rutham5fo/QuickPageLite/synth/rtl/qpl_synth_tb_func_synth.v

// Copyright 1986-2022 Xilinx, Inc. All Rights Reserved.
// Copyright 2022-2023 Advanced Micro Devices, Inc. All Rights Reserved.
// --------------------------------------------------------------------------------
// Tool Version: Vivado v.2023.2 (win64) Build 4029153 Fri Oct 13 20:14:34 MDT 2023
// Date        : Fri Jun 13 18:02:27 2025
// Host        : LAPTOP-SRGHD2GT running 64-bit major release  (build 9200)
// Command     : write_verilog -mode funcsim -nolib -force -file
//               C:/VivadoProjects/quick_page_lite/qpl_v2/qpl_v2.sim/sim_1/synth/func/xsim/qpl_synth_tb_func_synth.v
// Design      : qpl_top
// Purpose     : This verilog netlist is a functional simulation representation of the design and should not be modified
//               or synthesized. This netlist cannot be used for SDF annotated simulation.
// Device      : xc7z020clg400-1
// --------------------------------------------------------------------------------
`timescale 1 ps / 1 ps

module axis_fifo
   (i_req_alloc_vld,
    r_sready_reg_0,
    i_req_alloc_data,
    i_rst_IBUF,
    i_clk_IBUF_BUFG,
    o_req_alloc_rdy,
    i_req_alloc_vld_IBUF,
    D);
  output i_req_alloc_vld;
  output r_sready_reg_0;
  output [17:0]i_req_alloc_data;
  input i_rst_IBUF;
  input i_clk_IBUF_BUFG;
  input o_req_alloc_rdy;
  input i_req_alloc_vld_IBUF;
  input [17:0]D;

  wire [17:0]D;
  wire data0;
  wire data2;
  wire data3;
  wire data4;
  wire data5;
  wire data6;
  wire data7;
  wire i_clk_IBUF_BUFG;
  wire [17:0]i_req_alloc_data;
  wire i_req_alloc_vld;
  wire i_req_alloc_vld_IBUF;
  wire i_rst_IBUF;
  wire o_req_alloc_rdy;
  wire [3:0]p_0_in;
  wire p_14_in;
  wire p_1_in14_in;
  wire p_3_in10_in;
  wire p_5_in7_in;
  wire r_almost_full;
  wire r_almost_full_i_1_n_0;
  wire \r_data_buf[0][17]_i_1_n_0 ;
  wire \r_data_buf[1][17]_i_1_n_0 ;
  wire \r_data_buf[2][17]_i_1_n_0 ;
  wire \r_data_buf[3][17]_i_1_n_0 ;
  wire [17:0]\r_data_buf_reg[0] ;
  wire [17:0]\r_data_buf_reg[1] ;
  wire [17:0]\r_data_buf_reg[2] ;
  wire [17:0]\r_data_buf_reg[3] ;
  wire [17:0]\r_data_buf_reg[4] ;
  wire [17:0]\r_data_buf_reg[5] ;
  wire [17:0]\r_data_buf_reg[6] ;
  wire [17:0]\r_data_buf_reg[7] ;
  wire [2:0]r_rd_ptr;
  wire \r_rd_ptr[0]_i_1_n_0 ;
  wire \r_rd_ptr[1]_i_1_n_0 ;
  wire \r_rd_ptr[2]_i_1_n_0 ;
  wire \r_skid_cntr[3]_i_1_n_0 ;
  wire [3:0]r_skid_cntr_reg;
  wire r_sready_i_1_n_0;
  wire r_sready_reg_0;
  wire \r_valid_buf[0]_i_1_n_0 ;
  wire \r_valid_buf[0]_i_2_n_0 ;
  wire \r_valid_buf[1]_i_1_n_0 ;
  wire \r_valid_buf[1]_i_2_n_0 ;
  wire \r_valid_buf[2]_i_1_n_0 ;
  wire \r_valid_buf[2]_i_2_n_0 ;
  wire \r_valid_buf[3]_i_1_n_0 ;
  wire \r_valid_buf[3]_i_2_n_0 ;
  wire \r_valid_buf[4]_i_1_n_0 ;
  wire \r_valid_buf[5]_i_1_n_0 ;
  wire \r_valid_buf[6]_i_1_n_0 ;
  wire \r_valid_buf[7]_i_1_n_0 ;
  wire \r_valid_buf_reg_n_0_[7] ;
  wire [2:0]r_wr_ptr;
  wire \r_wr_ptr[0]_i_1_n_0 ;
  wire \r_wr_ptr[1]_i_1_n_0 ;
  wire \r_wr_ptr[2]_i_1_n_0 ;
  wire skid_mst_vld_i_n_1;
  wire skid_mst_vld_i_n_2;
  wire w_rd_valid;
  wire w_wr_valid;

  LUT6 #(
    .INIT(64'h0440800801102002)) 
    r_almost_full_i_1
       (.I0(r_rd_ptr[1]),
        .I1(r_rd_ptr[0]),
        .I2(r_rd_ptr[2]),
        .I3(r_wr_ptr[2]),
        .I4(r_wr_ptr[1]),
        .I5(r_wr_ptr[0]),
        .O(r_almost_full_i_1_n_0));
  FDRE #(
    .INIT(1'b0)) 
    r_almost_full_reg
       (.C(i_clk_IBUF_BUFG),
        .CE(1'b1),
        .D(r_almost_full_i_1_n_0),
        .Q(r_almost_full),
        .R(i_rst_IBUF));
  LUT4 #(
    .INIT(16'h0004)) 
    \r_data_buf[0][17]_i_1 
       (.I0(r_wr_ptr[1]),
        .I1(w_wr_valid),
        .I2(r_wr_ptr[0]),
        .I3(r_wr_ptr[2]),
        .O(\r_data_buf[0][17]_i_1_n_0 ));
  LUT4 #(
    .INIT(16'h0040)) 
    \r_data_buf[1][17]_i_1 
       (.I0(r_wr_ptr[1]),
        .I1(r_wr_ptr[0]),
        .I2(w_wr_valid),
        .I3(r_wr_ptr[2]),
        .O(\r_data_buf[1][17]_i_1_n_0 ));
  LUT4 #(
    .INIT(16'h0020)) 
    \r_data_buf[2][17]_i_1 
       (.I0(w_wr_valid),
        .I1(r_wr_ptr[0]),
        .I2(r_wr_ptr[1]),
        .I3(r_wr_ptr[2]),
        .O(\r_data_buf[2][17]_i_1_n_0 ));
  LUT4 #(
    .INIT(16'h0080)) 
    \r_data_buf[3][17]_i_1 
       (.I0(r_wr_ptr[0]),
        .I1(w_wr_valid),
        .I2(r_wr_ptr[1]),
        .I3(r_wr_ptr[2]),
        .O(\r_data_buf[3][17]_i_1_n_0 ));
  LUT4 #(
    .INIT(16'h0020)) 
    \r_data_buf[4][17]_i_1 
       (.I0(r_wr_ptr[2]),
        .I1(r_wr_ptr[1]),
        .I2(w_wr_valid),
        .I3(r_wr_ptr[0]),
        .O(p_5_in7_in));
  LUT4 #(
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
        .R(i_rst_IBUF));
  FDRE #(
    .INIT(1'b0)) 
    \r_data_buf_reg[7][5] 
       (.C(i_clk_IBUF_BUFG),
        .CE(p_14_in),
        .D(D[5]),
        .Q(\r_data_buf_reg[7] [5]),
        .R(i_rst_IBUF));
  FDRE #(
    .INIT(1'b0)) 
    \r_data_buf_reg[7][6] 
       (.C(i_clk_IBUF_BUFG),
        .CE(p_14_in),
        .D(D[6]),
        .Q(\r_data_buf_reg[7] [6]),
        .R(i_rst_IBUF));
  FDRE #(
    .INIT(1'b0)) 
    \r_data_buf_reg[7][7] 
       (.C(i_clk_IBUF_BUFG),
        .CE(p_14_in),
        .D(D[7]),
        .Q(\r_data_buf_reg[7] [7]),
        .R(i_rst_IBUF));
  FDRE #(
    .INIT(1'b0)) 
    \r_data_buf_reg[7][8] 
       (.C(i_clk_IBUF_BUFG),
        .CE(p_14_in),
        .D(D[8]),
        .Q(\r_data_buf_reg[7] [8]),
        .R(i_rst_IBUF));
  FDRE #(
    .INIT(1'b0)) 
    \r_data_buf_reg[7][9] 
       (.C(i_clk_IBUF_BUFG),
        .CE(p_14_in),
        .D(D[9]),
        .Q(\r_data_buf_reg[7] [9]),
        .R(i_rst_IBUF));
  LUT2 #(
    .INIT(4'h6)) 
    \r_rd_ptr[0]_i_1 
       (.I0(w_rd_valid),
        .I1(r_rd_ptr[0]),
        .O(\r_rd_ptr[0]_i_1_n_0 ));
  (* SOFT_HLUTNM = "soft_lutpair5" *) 
  LUT3 #(
    .INIT(8'h78)) 
    \r_rd_ptr[1]_i_1 
       (.I0(r_rd_ptr[0]),
        .I1(w_rd_valid),
        .I2(r_rd_ptr[1]),
        .O(\r_rd_ptr[1]_i_1_n_0 ));
  (* SOFT_HLUTNM = "soft_lutpair5" *) 
  LUT4 #(
    .INIT(16'h7F80)) 
    \r_rd_ptr[2]_i_1 
       (.I0(r_rd_ptr[0]),
        .I1(r_rd_ptr[1]),
        .I2(w_rd_valid),
        .I3(r_rd_ptr[2]),
        .O(\r_rd_ptr[2]_i_1_n_0 ));
  LUT6 #(
    .INIT(64'hA8A8A88A08080880)) 
    \r_rd_ptr[2]_i_2 
       (.I0(o_req_alloc_rdy),
        .I1(skid_mst_vld_i_n_2),
        .I2(r_rd_ptr[2]),
        .I3(r_rd_ptr[0]),
        .I4(r_rd_ptr[1]),
        .I5(skid_mst_vld_i_n_1),
        .O(w_rd_valid));
  FDRE #(
    .INIT(1'b0)) 
    \r_rd_ptr_reg[0] 
       (.C(i_clk_IBUF_BUFG),
        .CE(1'b1),
        .D(\r_rd_ptr[0]_i_1_n_0 ),
        .Q(r_rd_ptr[0]),
        .R(i_rst_IBUF));
  FDRE #(
    .INIT(1'b0)) 
    \r_rd_ptr_reg[1] 
       (.C(i_clk_IBUF_BUFG),
        .CE(1'b1),
        .D(\r_rd_ptr[1]_i_1_n_0 ),
        .Q(r_rd_ptr[1]),
        .R(i_rst_IBUF));
  FDRE #(
    .INIT(1'b0)) 
    \r_rd_ptr_reg[2] 
       (.C(i_clk_IBUF_BUFG),
        .CE(1'b1),
        .D(\r_rd_ptr[2]_i_1_n_0 ),
        .Q(r_rd_ptr[2]),
        .R(i_rst_IBUF));
  LUT3 #(
    .INIT(8'h56)) 
    \r_skid_cntr[0]_i_1 
       (.I0(r_skid_cntr_reg[0]),
        .I1(i_req_alloc_vld_IBUF),
        .I2(r_sready_reg_0),
        .O(p_0_in[0]));
  (* SOFT_HLUTNM = "soft_lutpair3" *) 
  LUT4 #(
    .INIT(16'h5BA4)) 
    \r_skid_cntr[1]_i_1 
       (.I0(r_skid_cntr_reg[0]),
        .I1(i_req_alloc_vld_IBUF),
        .I2(r_sready_reg_0),
        .I3(r_skid_cntr_reg[1]),
        .O(p_0_in[1]));
  (* SOFT_HLUTNM = "soft_lutpair3" *) 
  LUT5 #(
    .INIT(32'h77EF8810)) 
    \r_skid_cntr[2]_i_1 
       (.I0(r_skid_cntr_reg[0]),
        .I1(r_skid_cntr_reg[1]),
        .I2(i_req_alloc_vld_IBUF),
        .I3(r_sready_reg_0),
        .I4(r_skid_cntr_reg[2]),
        .O(p_0_in[2]));
  LUT5 #(
    .INIT(32'hFFFFFDFE)) 
    \r_skid_cntr[3]_i_1 
       (.I0(r_sready_reg_0),
        .I1(r_skid_cntr_reg[3]),
        .I2(r_skid_cntr_reg[2]),
        .I3(r_skid_cntr_reg[0]),
        .I4(r_skid_cntr_reg[1]),
        .O(\r_skid_cntr[3]_i_1_n_0 ));
  LUT6 #(
    .INIT(64'h7F7FFEFF80800100)) 
    \r_skid_cntr[3]_i_2 
       (.I0(r_skid_cntr_reg[1]),
        .I1(r_skid_cntr_reg[0]),
        .I2(r_skid_cntr_reg[2]),
        .I3(i_req_alloc_vld_IBUF),
        .I4(r_sready_reg_0),
        .I5(r_skid_cntr_reg[3]),
        .O(p_0_in[3]));
  FDRE #(
    .INIT(1'b0)) 
    \r_skid_cntr_reg[0] 
       (.C(i_clk_IBUF_BUFG),
        .CE(\r_skid_cntr[3]_i_1_n_0 ),
        .D(p_0_in[0]),
        .Q(r_skid_cntr_reg[0]),
        .R(i_rst_IBUF));
  FDRE #(
    .INIT(1'b0)) 
    \r_skid_cntr_reg[1] 
       (.C(i_clk_IBUF_BUFG),
        .CE(\r_skid_cntr[3]_i_1_n_0 ),
        .D(p_0_in[1]),
        .Q(r_skid_cntr_reg[1]),
        .R(i_rst_IBUF));
  FDRE #(
    .INIT(1'b0)) 
    \r_skid_cntr_reg[2] 
       (.C(i_clk_IBUF_BUFG),
        .CE(\r_skid_cntr[3]_i_1_n_0 ),
        .D(p_0_in[2]),
        .Q(r_skid_cntr_reg[2]),
        .R(i_rst_IBUF));
  FDRE #(
    .INIT(1'b0)) 
    \r_skid_cntr_reg[3] 
       (.C(i_clk_IBUF_BUFG),
        .CE(\r_skid_cntr[3]_i_1_n_0 ),
        .D(p_0_in[3]),
        .Q(r_skid_cntr_reg[3]),
        .R(i_rst_IBUF));
  LUT5 #(
    .INIT(32'hFFFFFC4C)) 
    r_sready_i_1
       (.I0(w_wr_valid),
        .I1(r_sready_reg_0),
        .I2(r_almost_full),
        .I3(w_rd_valid),
        .I4(i_rst_IBUF),
        .O(r_sready_i_1_n_0));
  FDRE #(
    .INIT(1'b0)) 
    r_sready_reg
       (.C(i_clk_IBUF_BUFG),
        .CE(1'b1),
        .D(r_sready_i_1_n_0),
        .Q(r_sready_reg_0),
        .R(1'b0));
  LUT5 #(
    .INIT(32'h0000EE0E)) 
    \r_valid_buf[0]_i_1 
       (.I0(data0),
        .I1(\r_data_buf[0][17]_i_1_n_0 ),
        .I2(\r_valid_buf[0]_i_2_n_0 ),
        .I3(r_rd_ptr[2]),
        .I4(i_rst_IBUF),
        .O(\r_valid_buf[0]_i_1_n_0 ));
  LUT6 #(
    .INIT(64'h0000000040444000)) 
    \r_valid_buf[0]_i_2 
       (.I0(r_rd_ptr[0]),
        .I1(o_req_alloc_rdy),
        .I2(skid_mst_vld_i_n_2),
        .I3(r_rd_ptr[2]),
        .I4(skid_mst_vld_i_n_1),
        .I5(r_rd_ptr[1]),
        .O(\r_valid_buf[0]_i_2_n_0 ));
  LUT5 #(
    .INIT(32'h0000EE0E)) 
    \r_valid_buf[1]_i_1 
       (.I0(data7),
        .I1(\r_data_buf[1][17]_i_1_n_0 ),
        .I2(\r_valid_buf[1]_i_2_n_0 ),
        .I3(r_rd_ptr[2]),
        .I4(i_rst_IBUF),
        .O(\r_valid_buf[1]_i_1_n_0 ));
  LUT6 #(
    .INIT(64'h00000000A8000800)) 
    \r_valid_buf[1]_i_2 
       (.I0(o_req_alloc_rdy),
        .I1(skid_mst_vld_i_n_2),
        .I2(r_rd_ptr[2]),
        .I3(r_rd_ptr[0]),
        .I4(skid_mst_vld_i_n_1),
        .I5(r_rd_ptr[1]),
        .O(\r_valid_buf[1]_i_2_n_0 ));
  LUT5 #(
    .INIT(32'h0000EE0E)) 
    \r_valid_buf[2]_i_1 
       (.I0(data6),
        .I1(\r_data_buf[2][17]_i_1_n_0 ),
        .I2(\r_valid_buf[2]_i_2_n_0 ),
        .I3(r_rd_ptr[2]),
        .I4(i_rst_IBUF),
        .O(\r_valid_buf[2]_i_1_n_0 ));
  LUT6 #(
    .INIT(64'h4440000000400000)) 
    \r_valid_buf[2]_i_2 
       (.I0(r_rd_ptr[0]),
        .I1(o_req_alloc_rdy),
        .I2(skid_mst_vld_i_n_2),
        .I3(r_rd_ptr[2]),
        .I4(r_rd_ptr[1]),
        .I5(skid_mst_vld_i_n_1),
        .O(\r_valid_buf[2]_i_2_n_0 ));
  LUT5 #(
    .INIT(32'h0000EE0E)) 
    \r_valid_buf[3]_i_1 
       (.I0(data5),
        .I1(\r_data_buf[3][17]_i_1_n_0 ),
        .I2(\r_valid_buf[3]_i_2_n_0 ),
        .I3(r_rd_ptr[2]),
        .I4(i_rst_IBUF),
        .O(\r_valid_buf[3]_i_1_n_0 ));
  LUT6 #(
    .INIT(64'hA800000008000000)) 
    \r_valid_buf[3]_i_2 
       (.I0(o_req_alloc_rdy),
        .I1(skid_mst_vld_i_n_2),
        .I2(r_rd_ptr[2]),
        .I3(r_rd_ptr[0]),
        .I4(r_rd_ptr[1]),
        .I5(skid_mst_vld_i_n_1),
        .O(\r_valid_buf[3]_i_2_n_0 ));
  LUT5 #(
    .INIT(32'h00000EEE)) 
    \r_valid_buf[4]_i_1 
       (.I0(data4),
        .I1(p_5_in7_in),
        .I2(r_rd_ptr[2]),
        .I3(\r_valid_buf[0]_i_2_n_0 ),
        .I4(i_rst_IBUF),
        .O(\r_valid_buf[4]_i_1_n_0 ));
  LUT5 #(
    .INIT(32'h00000EEE)) 
    \r_valid_buf[5]_i_1 
       (.I0(data3),
        .I1(p_3_in10_in),
        .I2(r_rd_ptr[2]),
        .I3(\r_valid_buf[1]_i_2_n_0 ),
        .I4(i_rst_IBUF),
        .O(\r_valid_buf[5]_i_1_n_0 ));
  LUT5 #(
    .INIT(32'h00000EEE)) 
    \r_valid_buf[6]_i_1 
       (.I0(data2),
        .I1(p_1_in14_in),
        .I2(r_rd_ptr[2]),
        .I3(\r_valid_buf[2]_i_2_n_0 ),
        .I4(i_rst_IBUF),
        .O(\r_valid_buf[6]_i_1_n_0 ));
  LUT5 #(
    .INIT(32'h00000EEE)) 
    \r_valid_buf[7]_i_1 
       (.I0(\r_valid_buf_reg_n_0_[7] ),
        .I1(p_14_in),
        .I2(r_rd_ptr[2]),
        .I3(\r_valid_buf[3]_i_2_n_0 ),
        .I4(i_rst_IBUF),
        .O(\r_valid_buf[7]_i_1_n_0 ));
  FDRE #(
    .INIT(1'b0)) 
    \r_valid_buf_reg[0] 
       (.C(i_clk_IBUF_BUFG),
        .CE(1'b1),
        .D(\r_valid_buf[0]_i_1_n_0 ),
        .Q(data0),
        .R(1'b0));
  FDRE #(
    .INIT(1'b0)) 
    \r_valid_buf_reg[1] 
       (.C(i_clk_IBUF_BUFG),
        .CE(1'b1),
        .D(\r_valid_buf[1]_i_1_n_0 ),
        .Q(data7),
        .R(1'b0));
  FDRE #(
    .INIT(1'b0)) 
    \r_valid_buf_reg[2] 
       (.C(i_clk_IBUF_BUFG),
        .CE(1'b1),
        .D(\r_valid_buf[2]_i_1_n_0 ),
        .Q(data6),
        .R(1'b0));
  FDRE #(
    .INIT(1'b0)) 
    \r_valid_buf_reg[3] 
       (.C(i_clk_IBUF_BUFG),
        .CE(1'b1),
        .D(\r_valid_buf[3]_i_1_n_0 ),
        .Q(data5),
        .R(1'b0));
  FDRE #(
    .INIT(1'b0)) 
    \r_valid_buf_reg[4] 
       (.C(i_clk_IBUF_BUFG),
        .CE(1'b1),
        .D(\r_valid_buf[4]_i_1_n_0 ),
        .Q(data4),
        .R(1'b0));
  FDRE #(
    .INIT(1'b0)) 
    \r_valid_buf_reg[5] 
       (.C(i_clk_IBUF_BUFG),
        .CE(1'b1),
        .D(\r_valid_buf[5]_i_1_n_0 ),
        .Q(data3),
        .R(1'b0));
  FDRE #(
    .INIT(1'b0)) 
    \r_valid_buf_reg[6] 
       (.C(i_clk_IBUF_BUFG),
        .CE(1'b1),
        .D(\r_valid_buf[6]_i_1_n_0 ),
        .Q(data2),
        .R(1'b0));
  FDRE #(
    .INIT(1'b0)) 
    \r_valid_buf_reg[7] 
       (.C(i_clk_IBUF_BUFG),
        .CE(1'b1),
        .D(\r_valid_buf[7]_i_1_n_0 ),
        .Q(\r_valid_buf_reg_n_0_[7] ),
        .R(1'b0));
  LUT2 #(
    .INIT(4'h6)) 
    \r_wr_ptr[0]_i_1 
       (.I0(w_wr_valid),
        .I1(r_wr_ptr[0]),
        .O(\r_wr_ptr[0]_i_1_n_0 ));
  (* SOFT_HLUTNM = "soft_lutpair4" *) 
  LUT3 #(
    .INIT(8'h78)) 
    \r_wr_ptr[1]_i_1 
       (.I0(r_wr_ptr[0]),
        .I1(w_wr_valid),
        .I2(r_wr_ptr[1]),
        .O(\r_wr_ptr[1]_i_1_n_0 ));
  (* SOFT_HLUTNM = "soft_lutpair4" *) 
  LUT4 #(
    .INIT(16'h7F80)) 
    \r_wr_ptr[2]_i_1 
       (.I0(r_wr_ptr[0]),
        .I1(r_wr_ptr[1]),
        .I2(w_wr_valid),
        .I3(r_wr_ptr[2]),
        .O(\r_wr_ptr[2]_i_1_n_0 ));
  LUT6 #(
    .INIT(64'hAAAAAAAAAAAAAAA8)) 
    \r_wr_ptr[2]_i_2 
       (.I0(i_req_alloc_vld_IBUF),
        .I1(r_skid_cntr_reg[1]),
        .I2(r_skid_cntr_reg[0]),
        .I3(r_skid_cntr_reg[3]),
        .I4(r_skid_cntr_reg[2]),
        .I5(r_sready_reg_0),
        .O(w_wr_valid));
  FDRE #(
    .INIT(1'b0)) 
    \r_wr_ptr_reg[0] 
       (.C(i_clk_IBUF_BUFG),
        .CE(1'b1),
        .D(\r_wr_ptr[0]_i_1_n_0 ),
        .Q(r_wr_ptr[0]),
        .R(i_rst_IBUF));
  FDRE #(
    .INIT(1'b0)) 
    \r_wr_ptr_reg[1] 
       (.C(i_clk_IBUF_BUFG),
        .CE(1'b1),
        .D(\r_wr_ptr[1]_i_1_n_0 ),
        .Q(r_wr_ptr[1]),
        .R(i_rst_IBUF));
  FDRE #(
    .INIT(1'b0)) 
    \r_wr_ptr_reg[2] 
       (.C(i_clk_IBUF_BUFG),
        .CE(1'b1),
        .D(\r_wr_ptr[2]_i_1_n_0 ),
        .Q(r_wr_ptr[2]),
        .R(i_rst_IBUF));
  skids__parameterized0 skid_mst_data_i
       (.Q(\r_data_buf_reg[3] ),
        .i_clk_IBUF_BUFG(i_clk_IBUF_BUFG),
        .i_req_alloc_data(i_req_alloc_data),
        .i_rst_IBUF(i_rst_IBUF),
        .o_req_alloc_rdy(o_req_alloc_rdy),
        .r_rd_ptr(r_rd_ptr),
        .\r_sreg_reg[17]_0 (\r_data_buf_reg[2] ),
        .\r_sreg_reg[17]_1 (\r_data_buf_reg[1] ),
        .\r_sreg_reg[17]_2 (\r_data_buf_reg[0] ),
        .\r_sreg_reg[17]_3 (\r_data_buf_reg[7] ),
        .\r_sreg_reg[17]_4 (\r_data_buf_reg[6] ),
        .\r_sreg_reg[17]_5 (\r_data_buf_reg[5] ),
        .\r_sreg_reg[17]_6 (\r_data_buf_reg[4] ));
  skids_12 skid_mst_vld_i
       (.data0(data0),
        .data2(data2),
        .data3(data3),
        .data4(data4),
        .data5(data5),
        .data6(data6),
        .data7(data7),
        .i_clk_IBUF_BUFG(i_clk_IBUF_BUFG),
        .i_req_alloc_vld(i_req_alloc_vld),
        .i_rst_IBUF(i_rst_IBUF),
        .o_req_alloc_rdy(o_req_alloc_rdy),
        .r_rd_ptr(r_rd_ptr),
        .\r_sreg_reg[0]_0 (\r_valid_buf_reg_n_0_[7] ),
        .\r_valid_buf_reg[3] (skid_mst_vld_i_n_2),
        .\r_valid_buf_reg[7] (skid_mst_vld_i_n_1));
endmodule

(* ORIG_REF_NAME = "axis_fifo" *) 
module axis_fifo__parameterized0
   (o_rep_alloc_vld_OBUF,
    r_sready_reg_0,
    o_rep_alloc_data_OBUF,
    i_rst_IBUF,
    i_clk_IBUF_BUFG,
    i_rep_alloc_rdy_IBUF,
    o_rep_alloc_vld,
    o_rep_alloc_data);
  output o_rep_alloc_vld_OBUF;
  output r_sready_reg_0;
  output [14:0]o_rep_alloc_data_OBUF;
  input i_rst_IBUF;
  input i_clk_IBUF_BUFG;
  input i_rep_alloc_rdy_IBUF;
  input o_rep_alloc_vld;
  input [14:0]o_rep_alloc_data;

  wire i_clk_IBUF_BUFG;
  wire i_rep_alloc_rdy_IBUF;
  wire i_rst_IBUF;
  wire [14:0]o_rep_alloc_data;
  wire [14:0]o_rep_alloc_data_OBUF;
  wire o_rep_alloc_vld;
  wire o_rep_alloc_vld_OBUF;
  wire [3:0]p_0_in__1;
  wire p_14_in;
  wire p_1_in14_in;
  wire p_3_in10_in;
  wire p_5_in7_in;
  wire r_almost_full;
  wire r_almost_full_i_1__1_n_0;
  wire \r_data_buf[0][14]_i_1__0_n_0 ;
  wire \r_data_buf[1][14]_i_1__0_n_0 ;
  wire \r_data_buf[2][14]_i_1__0_n_0 ;
  wire \r_data_buf[3][14]_i_1__0_n_0 ;
  wire \r_data_buf_reg_n_0_[0][0] ;
  wire \r_data_buf_reg_n_0_[0][10] ;
  wire \r_data_buf_reg_n_0_[0][11] ;
  wire \r_data_buf_reg_n_0_[0][12] ;
  wire \r_data_buf_reg_n_0_[0][13] ;
  wire \r_data_buf_reg_n_0_[0][14] ;
  wire \r_data_buf_reg_n_0_[0][1] ;
  wire \r_data_buf_reg_n_0_[0][2] ;
  wire \r_data_buf_reg_n_0_[0][3] ;
  wire \r_data_buf_reg_n_0_[0][4] ;
  wire \r_data_buf_reg_n_0_[0][5] ;
  wire \r_data_buf_reg_n_0_[0][6] ;
  wire \r_data_buf_reg_n_0_[0][7] ;
  wire \r_data_buf_reg_n_0_[0][8] ;
  wire \r_data_buf_reg_n_0_[0][9] ;
  wire \r_data_buf_reg_n_0_[1][0] ;
  wire \r_data_buf_reg_n_0_[1][10] ;
  wire \r_data_buf_reg_n_0_[1][11] ;
  wire \r_data_buf_reg_n_0_[1][12] ;
  wire \r_data_buf_reg_n_0_[1][13] ;
  wire \r_data_buf_reg_n_0_[1][14] ;
  wire \r_data_buf_reg_n_0_[1][1] ;
  wire \r_data_buf_reg_n_0_[1][2] ;
  wire \r_data_buf_reg_n_0_[1][3] ;
  wire \r_data_buf_reg_n_0_[1][4] ;
  wire \r_data_buf_reg_n_0_[1][5] ;
  wire \r_data_buf_reg_n_0_[1][6] ;
  wire \r_data_buf_reg_n_0_[1][7] ;
  wire \r_data_buf_reg_n_0_[1][8] ;
  wire \r_data_buf_reg_n_0_[1][9] ;
  wire \r_data_buf_reg_n_0_[2][0] ;
  wire \r_data_buf_reg_n_0_[2][10] ;
  wire \r_data_buf_reg_n_0_[2][11] ;
  wire \r_data_buf_reg_n_0_[2][12] ;
  wire \r_data_buf_reg_n_0_[2][13] ;
  wire \r_data_buf_reg_n_0_[2][14] ;
  wire \r_data_buf_reg_n_0_[2][1] ;
  wire \r_data_buf_reg_n_0_[2][2] ;
  wire \r_data_buf_reg_n_0_[2][3] ;
  wire \r_data_buf_reg_n_0_[2][4] ;
  wire \r_data_buf_reg_n_0_[2][5] ;
  wire \r_data_buf_reg_n_0_[2][6] ;
  wire \r_data_buf_reg_n_0_[2][7] ;
  wire \r_data_buf_reg_n_0_[2][8] ;
  wire \r_data_buf_reg_n_0_[2][9] ;
  wire \r_data_buf_reg_n_0_[3][0] ;
  wire \r_data_buf_reg_n_0_[3][10] ;
  wire \r_data_buf_reg_n_0_[3][11] ;
  wire \r_data_buf_reg_n_0_[3][12] ;
  wire \r_data_buf_reg_n_0_[3][13] ;
  wire \r_data_buf_reg_n_0_[3][14] ;
  wire \r_data_buf_reg_n_0_[3][1] ;
  wire \r_data_buf_reg_n_0_[3][2] ;
  wire \r_data_buf_reg_n_0_[3][3] ;
  wire \r_data_buf_reg_n_0_[3][4] ;
  wire \r_data_buf_reg_n_0_[3][5] ;
  wire \r_data_buf_reg_n_0_[3][6] ;
  wire \r_data_buf_reg_n_0_[3][7] ;
  wire \r_data_buf_reg_n_0_[3][8] ;
  wire \r_data_buf_reg_n_0_[3][9] ;
  wire \r_data_buf_reg_n_0_[4][0] ;
  wire \r_data_buf_reg_n_0_[4][10] ;
  wire \r_data_buf_reg_n_0_[4][11] ;
  wire \r_data_buf_reg_n_0_[4][12] ;
  wire \r_data_buf_reg_n_0_[4][13] ;
  wire \r_data_buf_reg_n_0_[4][14] ;
  wire \r_data_buf_reg_n_0_[4][1] ;
  wire \r_data_buf_reg_n_0_[4][2] ;
  wire \r_data_buf_reg_n_0_[4][3] ;
  wire \r_data_buf_reg_n_0_[4][4] ;
  wire \r_data_buf_reg_n_0_[4][5] ;
  wire \r_data_buf_reg_n_0_[4][6] ;
  wire \r_data_buf_reg_n_0_[4][7] ;
  wire \r_data_buf_reg_n_0_[4][8] ;
  wire \r_data_buf_reg_n_0_[4][9] ;
  wire \r_data_buf_reg_n_0_[5][0] ;
  wire \r_data_buf_reg_n_0_[5][10] ;
  wire \r_data_buf_reg_n_0_[5][11] ;
  wire \r_data_buf_reg_n_0_[5][12] ;
  wire \r_data_buf_reg_n_0_[5][13] ;
  wire \r_data_buf_reg_n_0_[5][14] ;
  wire \r_data_buf_reg_n_0_[5][1] ;
  wire \r_data_buf_reg_n_0_[5][2] ;
  wire \r_data_buf_reg_n_0_[5][3] ;
  wire \r_data_buf_reg_n_0_[5][4] ;
  wire \r_data_buf_reg_n_0_[5][5] ;
  wire \r_data_buf_reg_n_0_[5][6] ;
  wire \r_data_buf_reg_n_0_[5][7] ;
  wire \r_data_buf_reg_n_0_[5][8] ;
  wire \r_data_buf_reg_n_0_[5][9] ;
  wire \r_data_buf_reg_n_0_[6][0] ;
  wire \r_data_buf_reg_n_0_[6][10] ;
  wire \r_data_buf_reg_n_0_[6][11] ;
  wire \r_data_buf_reg_n_0_[6][12] ;
  wire \r_data_buf_reg_n_0_[6][13] ;
  wire \r_data_buf_reg_n_0_[6][14] ;
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
    \r_rd_ptr[1]_i_1 
       (.I0(\r_rd_ptr_reg_n_0_[0] ),
        .I1(w_rd_valid),
        .I2(\r_rd_ptr_reg_n_0_[1] ),
        .O(\r_rd_ptr[1]_i_1_n_0 ));
  (* SOFT_HLUTNM = "soft_lutpair1" *) 
  LUT4 #(
    .INIT(16'h7F80)) 
    \r_rd_ptr[2]_i_1 
       (.I0(\r_rd_ptr_reg_n_0_[0] ),
        .I1(\r_rd_ptr_reg_n_0_[1] ),
        .I2(w_rd_valid),
        .I3(\r_rd_ptr_reg_n_0_[2] ),
        .O(\r_rd_ptr[2]_i_1_n_0 ));
  LUT6 #(
    .INIT(64'hA8A8A88A08080880)) 
    \r_rd_ptr[2]_i_2__1 
       (.I0(i_rep_alloc_rdy_IBUF),
        .I1(skid_mst_vld_i_n_2),
        .I2(\r_rd_ptr_reg_n_0_[2] ),
        .I3(\r_rd_ptr_reg_n_0_[0] ),
        .I4(\r_rd_ptr_reg_n_0_[1] ),
        .I5(skid_mst_vld_i_n_1),
        .O(w_rd_valid));
  FDRE #(
    .INIT(1'b0)) 
    \r_rd_ptr_reg[0] 
       (.C(i_clk_IBUF_BUFG),
        .CE(1'b1),
        .D(\r_rd_ptr[0]_i_1_n_0 ),
        .Q(\r_rd_ptr_reg_n_0_[0] ),
        .R(i_rst_IBUF));
  FDRE #(
    .INIT(1'b0)) 
    \r_rd_ptr_reg[1] 
       (.C(i_clk_IBUF_BUFG),
        .CE(1'b1),
        .D(\r_rd_ptr[1]_i_1_n_0 ),
        .Q(\r_rd_ptr_reg_n_0_[1] ),
        .R(i_rst_IBUF));
  FDRE #(
    .INIT(1'b0)) 
    \r_rd_ptr_reg[2] 
       (.C(i_clk_IBUF_BUFG),
        .CE(1'b1),
        .D(\r_rd_ptr[2]_i_1_n_0 ),
        .Q(\r_rd_ptr_reg_n_0_[2] ),
        .R(i_rst_IBUF));
  LUT3 #(
    .INIT(8'h56)) 
    \r_skid_cntr[0]_i_1__1 
       (.I0(r_skid_cntr_reg[0]),
        .I1(o_rep_alloc_vld),
        .I2(r_sready_reg_0),
        .O(p_0_in__1[0]));
  (* SOFT_HLUTNM = "soft_lutpair0" *) 
  LUT4 #(
    .INIT(16'h5BA4)) 
    \r_skid_cntr[1]_i_1__1 
       (.I0(r_skid_cntr_reg[0]),
        .I1(o_rep_alloc_vld),
        .I2(r_sready_reg_0),
        .I3(r_skid_cntr_reg[1]),
        .O(p_0_in__1[1]));
  (* SOFT_HLUTNM = "soft_lutpair0" *) 
  LUT5 #(
    .INIT(32'h77EF8810)) 
    \r_skid_cntr[2]_i_1__1 
       (.I0(r_skid_cntr_reg[0]),
        .I1(r_skid_cntr_reg[1]),
        .I2(o_rep_alloc_vld),
        .I3(r_sready_reg_0),
        .I4(r_skid_cntr_reg[2]),
        .O(p_0_in__1[2]));
  LUT5 #(
    .INIT(32'hFFFFFDFE)) 
    \r_skid_cntr[3]_i_1__1 
       (.I0(r_sready_reg_0),
        .I1(r_skid_cntr_reg[3]),
        .I2(r_skid_cntr_reg[2]),
        .I3(r_skid_cntr_reg[0]),
        .I4(r_skid_cntr_reg[1]),
        .O(\r_skid_cntr[3]_i_1__1_n_0 ));
  LUT6 #(
    .INIT(64'h7F7FFEFF80800100)) 
    \r_skid_cntr[3]_i_2__1 
       (.I0(r_skid_cntr_reg[1]),
        .I1(r_skid_cntr_reg[0]),
        .I2(r_skid_cntr_reg[2]),
        .I3(o_rep_alloc_vld),
        .I4(r_sready_reg_0),
        .I5(r_skid_cntr_reg[3]),
        .O(p_0_in__1[3]));
  FDRE #(
    .INIT(1'b0)) 
    \r_skid_cntr_reg[0] 
       (.C(i_clk_IBUF_BUFG),
        .CE(\r_skid_cntr[3]_i_1__1_n_0 ),
        .D(p_0_in__1[0]),
        .Q(r_skid_cntr_reg[0]),
        .R(i_rst_IBUF));
  FDRE #(
    .INIT(1'b0)) 
    \r_skid_cntr_reg[1] 
       (.C(i_clk_IBUF_BUFG),
        .CE(\r_skid_cntr[3]_i_1__1_n_0 ),
        .D(p_0_in__1[1]),
        .Q(r_skid_cntr_reg[1]),
        .R(i_rst_IBUF));
  FDRE #(
    .INIT(1'b0)) 
    \r_skid_cntr_reg[2] 
       (.C(i_clk_IBUF_BUFG),
        .CE(\r_skid_cntr[3]_i_1__1_n_0 ),
        .D(p_0_in__1[2]),
        .Q(r_skid_cntr_reg[2]),
        .R(i_rst_IBUF));
  FDRE #(
    .INIT(1'b0)) 
    \r_skid_cntr_reg[3] 
       (.C(i_clk_IBUF_BUFG),
        .CE(\r_skid_cntr[3]_i_1__1_n_0 ),
        .D(p_0_in__1[3]),
        .Q(r_skid_cntr_reg[3]),
        .R(i_rst_IBUF));
  LUT5 #(
    .INIT(32'hFFFFFC4C)) 
    r_sready_i_1__1
       (.I0(w_wr_valid),
        .I1(r_sready_reg_0),
        .I2(r_almost_full),
        .I3(w_rd_valid),
        .I4(i_rst_IBUF),
        .O(r_sready_i_1__1_n_0));
  FDRE #(
    .INIT(1'b0)) 
    r_sready_reg
       (.C(i_clk_IBUF_BUFG),
        .CE(1'b1),
        .D(r_sready_i_1__1_n_0),
        .Q(r_sready_reg_0),
        .R(1'b0));
  LUT5 #(
    .INIT(32'h0000EE0E)) 
    \r_valid_buf[0]_i_1__1 
       (.I0(\r_valid_buf_reg_n_0_[0] ),
        .I1(\r_data_buf[0][14]_i_1__0_n_0 ),
        .I2(\r_valid_buf[0]_i_2__1_n_0 ),
        .I3(\r_rd_ptr_reg_n_0_[2] ),
        .I4(i_rst_IBUF),
        .O(\r_valid_buf[0]_i_1__1_n_0 ));
  LUT6 #(
    .INIT(64'h0000000040444000)) 
    \r_valid_buf[0]_i_2__1 
       (.I0(\r_rd_ptr_reg_n_0_[0] ),
        .I1(i_rep_alloc_rdy_IBUF),
        .I2(skid_mst_vld_i_n_2),
        .I3(\r_rd_ptr_reg_n_0_[2] ),
        .I4(skid_mst_vld_i_n_1),
        .I5(\r_rd_ptr_reg_n_0_[1] ),
        .O(\r_valid_buf[0]_i_2__1_n_0 ));
  LUT5 #(
    .INIT(32'h0000EE0E)) 
    \r_valid_buf[1]_i_1__1 
       (.I0(\r_valid_buf_reg_n_0_[1] ),
        .I1(\r_data_buf[1][14]_i_1__0_n_0 ),
        .I2(\r_valid_buf[1]_i_2__1_n_0 ),
        .I3(\r_rd_ptr_reg_n_0_[2] ),
        .I4(i_rst_IBUF),
        .O(\r_valid_buf[1]_i_1__1_n_0 ));
  LUT6 #(
    .INIT(64'h00000000A8000800)) 
    \r_valid_buf[1]_i_2__1 
       (.I0(i_rep_alloc_rdy_IBUF),
        .I1(skid_mst_vld_i_n_2),
        .I2(\r_rd_ptr_reg_n_0_[2] ),
        .I3(\r_rd_ptr_reg_n_0_[0] ),
        .I4(skid_mst_vld_i_n_1),
        .I5(\r_rd_ptr_reg_n_0_[1] ),
        .O(\r_valid_buf[1]_i_2__1_n_0 ));
  LUT5 #(
    .INIT(32'h0000EE0E)) 
    \r_valid_buf[2]_i_1__1 
       (.I0(\r_valid_buf_reg_n_0_[2] ),
        .I1(\r_data_buf[2][14]_i_1__0_n_0 ),
        .I2(\r_valid_buf[2]_i_2__1_n_0 ),
        .I3(\r_rd_ptr_reg_n_0_[2] ),
        .I4(i_rst_IBUF),
        .O(\r_valid_buf[2]_i_1__1_n_0 ));
  LUT6 #(
    .INIT(64'h4440000000400000)) 
    \r_valid_buf[2]_i_2__1 
       (.I0(\r_rd_ptr_reg_n_0_[0] ),
        .I1(i_rep_alloc_rdy_IBUF),
        .I2(skid_mst_vld_i_n_2),
        .I3(\r_rd_ptr_reg_n_0_[2] ),
        .I4(\r_rd_ptr_reg_n_0_[1] ),
        .I5(skid_mst_vld_i_n_1),
        .O(\r_valid_buf[2]_i_2__1_n_0 ));
  LUT5 #(
    .INIT(32'h0000EE0E)) 
    \r_valid_buf[3]_i_1__1 
       (.I0(\r_valid_buf_reg_n_0_[3] ),
        .I1(\r_data_buf[3][14]_i_1__0_n_0 ),
        .I2(\r_valid_buf[3]_i_2__1_n_0 ),
        .I3(\r_rd_ptr_reg_n_0_[2] ),
        .I4(i_rst_IBUF),
        .O(\r_valid_buf[3]_i_1__1_n_0 ));
  LUT6 #(
    .INIT(64'hA800000008000000)) 
    \r_valid_buf[3]_i_2__1 
       (.I0(i_rep_alloc_rdy_IBUF),
        .I1(skid_mst_vld_i_n_2),
        .I2(\r_rd_ptr_reg_n_0_[2] ),
        .I3(\r_rd_ptr_reg_n_0_[0] ),
        .I4(\r_rd_ptr_reg_n_0_[1] ),
        .I5(skid_mst_vld_i_n_1),
        .O(\r_valid_buf[3]_i_2__1_n_0 ));
  LUT5 #(
    .INIT(32'h00000EEE)) 
    \r_valid_buf[4]_i_1__1 
       (.I0(\r_valid_buf_reg_n_0_[4] ),
        .I1(p_5_in7_in),
        .I2(\r_rd_ptr_reg_n_0_[2] ),
        .I3(\r_valid_buf[0]_i_2__1_n_0 ),
        .I4(i_rst_IBUF),
        .O(\r_valid_buf[4]_i_1__1_n_0 ));
  LUT5 #(
    .INIT(32'h00000EEE)) 
    \r_valid_buf[5]_i_1__1 
       (.I0(\r_valid_buf_reg_n_0_[5] ),
        .I1(p_3_in10_in),
        .I2(\r_rd_ptr_reg_n_0_[2] ),
        .I3(\r_valid_buf[1]_i_2__1_n_0 ),
        .I4(i_rst_IBUF),
        .O(\r_valid_buf[5]_i_1__1_n_0 ));
  LUT5 #(
    .INIT(32'h00000EEE)) 
    \r_valid_buf[6]_i_1__1 
       (.I0(\r_valid_buf_reg_n_0_[6] ),
        .I1(p_1_in14_in),
        .I2(\r_rd_ptr_reg_n_0_[2] ),
        .I3(\r_valid_buf[2]_i_2__1_n_0 ),
        .I4(i_rst_IBUF),
        .O(\r_valid_buf[6]_i_1__1_n_0 ));
  LUT5 #(
    .INIT(32'h00000EEE)) 
    \r_valid_buf[7]_i_1__1 
       (.I0(\r_valid_buf_reg_n_0_[7] ),
        .I1(p_14_in),
        .I2(\r_rd_ptr_reg_n_0_[2] ),
        .I3(\r_valid_buf[3]_i_2__1_n_0 ),
        .I4(i_rst_IBUF),
        .O(\r_valid_buf[7]_i_1__1_n_0 ));
  FDRE #(
    .INIT(1'b0)) 
    \r_valid_buf_reg[0] 
       (.C(i_clk_IBUF_BUFG),
        .CE(1'b1),
        .D(\r_valid_buf[0]_i_1__1_n_0 ),
        .Q(\r_valid_buf_reg_n_0_[0] ),
        .R(1'b0));
  FDRE #(
    .INIT(1'b0)) 
    \r_valid_buf_reg[1] 
       (.C(i_clk_IBUF_BUFG),
        .CE(1'b1),
        .D(\r_valid_buf[1]_i_1__1_n_0 ),
        .Q(\r_valid_buf_reg_n_0_[1] ),
        .R(1'b0));
  FDRE #(
    .INIT(1'b0)) 
    \r_valid_buf_reg[2] 
       (.C(i_clk_IBUF_BUFG),
        .CE(1'b1),
        .D(\r_valid_buf[2]_i_1__1_n_0 ),
        .Q(\r_valid_buf_reg_n_0_[2] ),
        .R(1'b0));
  FDRE #(
    .INIT(1'b0)) 
    \r_valid_buf_reg[3] 
       (.C(i_clk_IBUF_BUFG),
        .CE(1'b1),
        .D(\r_valid_buf[3]_i_1__1_n_0 ),
        .Q(\r_valid_buf_reg_n_0_[3] ),
        .R(1'b0));
  FDRE #(
    .INIT(1'b0)) 
    \r_valid_buf_reg[4] 
       (.C(i_clk_IBUF_BUFG),
        .CE(1'b1),
        .D(\r_valid_buf[4]_i_1__1_n_0 ),
        .Q(\r_valid_buf_reg_n_0_[4] ),
        .R(1'b0));
  FDRE #(
    .INIT(1'b0)) 
    \r_valid_buf_reg[5] 
       (.C(i_clk_IBUF_BUFG),
        .CE(1'b1),
        .D(\r_valid_buf[5]_i_1__1_n_0 ),
        .Q(\r_valid_buf_reg_n_0_[5] ),
        .R(1'b0));
  FDRE #(
    .INIT(1'b0)) 
    \r_valid_buf_reg[6] 
       (.C(i_clk_IBUF_BUFG),
        .CE(1'b1),
        .D(\r_valid_buf[6]_i_1__1_n_0 ),
        .Q(\r_valid_buf_reg_n_0_[6] ),
        .R(1'b0));
  FDRE #(
    .INIT(1'b0)) 
    \r_valid_buf_reg[7] 
       (.C(i_clk_IBUF_BUFG),
        .CE(1'b1),
        .D(\r_valid_buf[7]_i_1__1_n_0 ),
        .Q(\r_valid_buf_reg_n_0_[7] ),
        .R(1'b0));
  LUT2 #(
    .INIT(4'h6)) 
    \r_wr_ptr[0]_i_1 
       (.I0(w_wr_valid),
        .I1(\r_wr_ptr_reg_n_0_[0] ),
        .O(\r_wr_ptr[0]_i_1_n_0 ));
  (* SOFT_HLUTNM = "soft_lutpair2" *) 
  LUT3 #(
    .INIT(8'h78)) 
    \r_wr_ptr[1]_i_1 
       (.I0(\r_wr_ptr_reg_n_0_[0] ),
        .I1(w_wr_valid),
        .I2(\r_wr_ptr_reg_n_0_[1] ),
        .O(\r_wr_ptr[1]_i_1_n_0 ));
  (* SOFT_HLUTNM = "soft_lutpair2" *) 
  LUT4 #(
    .INIT(16'h7F80)) 
    \r_wr_ptr[2]_i_1 
       (.I0(\r_wr_ptr_reg_n_0_[0] ),
        .I1(\r_wr_ptr_reg_n_0_[1] ),
        .I2(w_wr_valid),
        .I3(\r_wr_ptr_reg_n_0_[2] ),
        .O(\r_wr_ptr[2]_i_1_n_0 ));
  LUT6 #(
    .INIT(64'hAAAAAAAAAAAAAAA8)) 
    \r_wr_ptr[2]_i_2__1 
       (.I0(o_rep_alloc_vld),
        .I1(r_skid_cntr_reg[1]),
        .I2(r_skid_cntr_reg[0]),
        .I3(r_skid_cntr_reg[3]),
        .I4(r_skid_cntr_reg[2]),
        .I5(r_sready_reg_0),
        .O(w_wr_valid));
  FDRE #(
    .INIT(1'b0)) 
    \r_wr_ptr_reg[0] 
       (.C(i_clk_IBUF_BUFG),
        .CE(1'b1),
        .D(\r_wr_ptr[0]_i_1_n_0 ),
        .Q(\r_wr_ptr_reg_n_0_[0] ),
        .R(i_rst_IBUF));
  FDRE #(
    .INIT(1'b0)) 
    \r_wr_ptr_reg[1] 
       (.C(i_clk_IBUF_BUFG),
        .CE(1'b1),
        .D(\r_wr_ptr[1]_i_1_n_0 ),
        .Q(\r_wr_ptr_reg_n_0_[1] ),
        .R(i_rst_IBUF));
  FDRE #(
    .INIT(1'b0)) 
    \r_wr_ptr_reg[2] 
       (.C(i_clk_IBUF_BUFG),
        .CE(1'b1),
        .D(\r_wr_ptr[2]_i_1_n_0 ),
        .Q(\r_wr_ptr_reg_n_0_[2] ),
        .R(i_rst_IBUF));
  skids__parameterized1_13 skid_mst_data_i
       (.Q({\r_data_buf_reg_n_0_[3][14] ,\r_data_buf_reg_n_0_[3][13] ,\r_data_buf_reg_n_0_[3][12] ,\r_data_buf_reg_n_0_[3][11] ,\r_data_buf_reg_n_0_[3][10] ,\r_data_buf_reg_n_0_[3][9] ,\r_data_buf_reg_n_0_[3][8] ,\r_data_buf_reg_n_0_[3][7] ,\r_data_buf_reg_n_0_[3][6] ,\r_data_buf_reg_n_0_[3][5] ,\r_data_buf_reg_n_0_[3][4] ,\r_data_buf_reg_n_0_[3][3] ,\r_data_buf_reg_n_0_[3][2] ,\r_data_buf_reg_n_0_[3][1] ,\r_data_buf_reg_n_0_[3][0] }),
        .i_clk_IBUF_BUFG(i_clk_IBUF_BUFG),
        .i_rep_alloc_rdy_IBUF(i_rep_alloc_rdy_IBUF),
        .i_rst_IBUF(i_rst_IBUF),
        .o_rep_alloc_data_OBUF(o_rep_alloc_data_OBUF),
        .\r_sreg_reg[0]_0 (\r_rd_ptr_reg_n_0_[2] ),
        .\r_sreg_reg[0]_1 (\r_rd_ptr_reg_n_0_[1] ),
        .\r_sreg_reg[0]_2 (\r_rd_ptr_reg_n_0_[0] ),
        .\r_sreg_reg[14]_0 ({\r_data_buf_reg_n_0_[2][14] ,\r_data_buf_reg_n_0_[2][13] ,\r_data_buf_reg_n_0_[2][12] ,\r_data_buf_reg_n_0_[2][11] ,\r_data_buf_reg_n_0_[2][10] ,\r_data_buf_reg_n_0_[2][9] ,\r_data_buf_reg_n_0_[2][8] ,\r_data_buf_reg_n_0_[2][7] ,\r_data_buf_reg_n_0_[2][6] ,\r_data_buf_reg_n_0_[2][5] ,\r_data_buf_reg_n_0_[2][4] ,\r_data_buf_reg_n_0_[2][3] ,\r_data_buf_reg_n_0_[2][2] ,\r_data_buf_reg_n_0_[2][1] ,\r_data_buf_reg_n_0_[2][0] }),
        .\r_sreg_reg[14]_1 ({\r_data_buf_reg_n_0_[1][14] ,\r_data_buf_reg_n_0_[1][13] ,\r_data_buf_reg_n_0_[1][12] ,\r_data_buf_reg_n_0_[1][11] ,\r_data_buf_reg_n_0_[1][10] ,\r_data_buf_reg_n_0_[1][9] ,\r_data_buf_reg_n_0_[1][8] ,\r_data_buf_reg_n_0_[1][7] ,\r_data_buf_reg_n_0_[1][6] ,\r_data_buf_reg_n_0_[1][5] ,\r_data_buf_reg_n_0_[1][4] ,\r_data_buf_reg_n_0_[1][3] ,\r_data_buf_reg_n_0_[1][2] ,\r_data_buf_reg_n_0_[1][1] ,\r_data_buf_reg_n_0_[1][0] }),
        .\r_sreg_reg[14]_2 ({\r_data_buf_reg_n_0_[0][14] ,\r_data_buf_reg_n_0_[0][13] ,\r_data_buf_reg_n_0_[0][12] ,\r_data_buf_reg_n_0_[0][11] ,\r_data_buf_reg_n_0_[0][10] ,\r_data_buf_reg_n_0_[0][9] ,\r_data_buf_reg_n_0_[0][8] ,\r_data_buf_reg_n_0_[0][7] ,\r_data_buf_reg_n_0_[0][6] ,\r_data_buf_reg_n_0_[0][5] ,\r_data_buf_reg_n_0_[0][4] ,\r_data_buf_reg_n_0_[0][3] ,\r_data_buf_reg_n_0_[0][2] ,\r_data_buf_reg_n_0_[0][1] ,\r_data_buf_reg_n_0_[0][0] }),
        .\r_sreg_reg[14]_3 ({\r_data_buf_reg_n_0_[7][14] ,\r_data_buf_reg_n_0_[7][13] ,\r_data_buf_reg_n_0_[7][12] ,\r_data_buf_reg_n_0_[7][11] ,\r_data_buf_reg_n_0_[7][10] ,\r_data_buf_reg_n_0_[7][9] ,\r_data_buf_reg_n_0_[7][8] ,\r_data_buf_reg_n_0_[7][7] ,\r_data_buf_reg_n_0_[7][6] ,\r_data_buf_reg_n_0_[7][5] ,\r_data_buf_reg_n_0_[7][4] ,\r_data_buf_reg_n_0_[7][3] ,\r_data_buf_reg_n_0_[7][2] ,\r_data_buf_reg_n_0_[7][1] ,\r_data_buf_reg_n_0_[7][0] }),
        .\r_sreg_reg[14]_4 ({\r_data_buf_reg_n_0_[6][14] ,\r_data_buf_reg_n_0_[6][13] ,\r_data_buf_reg_n_0_[6][12] ,\r_data_buf_reg_n_0_[6][11] ,\r_data_buf_reg_n_0_[6][10] ,\r_data_buf_reg_n_0_[6][9] ,\r_data_buf_reg_n_0_[6][8] ,\r_data_buf_reg_n_0_[6][7] ,\r_data_buf_reg_n_0_[6][6] ,\r_data_buf_reg_n_0_[6][5] ,\r_data_buf_reg_n_0_[6][4] ,\r_data_buf_reg_n_0_[6][3] ,\r_data_buf_reg_n_0_[6][2] ,\r_data_buf_reg_n_0_[6][1] ,\r_data_buf_reg_n_0_[6][0] }),
        .\r_sreg_reg[14]_5 ({\r_data_buf_reg_n_0_[5][14] ,\r_data_buf_reg_n_0_[5][13] ,\r_data_buf_reg_n_0_[5][12] ,\r_data_buf_reg_n_0_[5][11] ,\r_data_buf_reg_n_0_[5][10] ,\r_data_buf_reg_n_0_[5][9] ,\r_data_buf_reg_n_0_[5][8] ,\r_data_buf_reg_n_0_[5][7] ,\r_data_buf_reg_n_0_[5][6] ,\r_data_buf_reg_n_0_[5][5] ,\r_data_buf_reg_n_0_[5][4] ,\r_data_buf_reg_n_0_[5][3] ,\r_data_buf_reg_n_0_[5][2] ,\r_data_buf_reg_n_0_[5][1] ,\r_data_buf_reg_n_0_[5][0] }),
        .\r_sreg_reg[14]_6 ({\r_data_buf_reg_n_0_[4][14] ,\r_data_buf_reg_n_0_[4][13] ,\r_data_buf_reg_n_0_[4][12] ,\r_data_buf_reg_n_0_[4][11] ,\r_data_buf_reg_n_0_[4][10] ,\r_data_buf_reg_n_0_[4][9] ,\r_data_buf_reg_n_0_[4][8] ,\r_data_buf_reg_n_0_[4][7] ,\r_data_buf_reg_n_0_[4][6] ,\r_data_buf_reg_n_0_[4][5] ,\r_data_buf_reg_n_0_[4][4] ,\r_data_buf_reg_n_0_[4][3] ,\r_data_buf_reg_n_0_[4][2] ,\r_data_buf_reg_n_0_[4][1] ,\r_data_buf_reg_n_0_[4][0] }));
  skids_14 skid_mst_vld_i
       (.i_clk_IBUF_BUFG(i_clk_IBUF_BUFG),
        .i_rep_alloc_rdy_IBUF(i_rep_alloc_rdy_IBUF),
        .i_rst_IBUF(i_rst_IBUF),
        .o_rep_alloc_vld_OBUF(o_rep_alloc_vld_OBUF),
        .\r_sreg_reg[0]_0 (\r_rd_ptr_reg_n_0_[1] ),
        .\r_sreg_reg[0]_1 (\r_rd_ptr_reg_n_0_[0] ),
        .\r_sreg_reg[0]_10 (\r_valid_buf_reg_n_0_[2] ),
        .\r_sreg_reg[0]_2 (\r_rd_ptr_reg_n_0_[2] ),
        .\r_sreg_reg[0]_3 (\r_valid_buf_reg_n_0_[7] ),
        .\r_sreg_reg[0]_4 (\r_valid_buf_reg_n_0_[0] ),
        .\r_sreg_reg[0]_5 (\r_valid_buf_reg_n_0_[5] ),
        .\r_sreg_reg[0]_6 (\r_valid_buf_reg_n_0_[6] ),
        .\r_sreg_reg[0]_7 (\r_valid_buf_reg_n_0_[3] ),
        .\r_sreg_reg[0]_8 (\r_valid_buf_reg_n_0_[4] ),
        .\r_sreg_reg[0]_9 (\r_valid_buf_reg_n_0_[1] ),
        .\r_valid_buf_reg[3] (skid_mst_vld_i_n_2),
        .\r_valid_buf_reg[7] (skid_mst_vld_i_n_1));
endmodule
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
