rutham5fo/QuickPageLite/example/qpl_1wNr_heap/mem_heap.sv

`timescale 1ns / 1ps
//////////////////////////////////////////////////////////////////////////////////
// Company: 
// Engineer: 
// 
// Create Date: 13.06.2025 20:13:23
// Design Name: 
// Module Name: mem_heap
// Project Name: 
// Target Devices: 
// Tool Versions: 
// Description: 
// 
// Dependencies: 
// 
// Revision:
// Revision 0.01 - File Created
// Additional Comments:
// 
//////////////////////////////////////////////////////////////////////////////////

/*
module mem_heap #(
        parameter BLOCK_D               = 128,                  // Number of lines per block
        parameter CHANS                 = 3,                    // Total number of address channels per block
        parameter LINE_BYTE             = 64,                   // Number of bytes per line
        //------------ DERIVED ------------------
        localparam BLOCK_W              = $clog2(BLOCK_D),
        localparam ADDR_W               = BLOCK_W,
        localparam DATA_W               = LINE_BYTE * 8
    )(
        input wire                              i_clk,
        input wire                              i_rst,
        input wire  [CHANS-1:0]                 i_wr_en,
        input wire  [CHANS-1:0][BLOCK_W-1:0]    i_wr_addr,
        input wire  [CHANS-1:0][BLOCK_W-1:0]    i_rd_addr,
        input wire  [CHANS-1:0][DATA_W-1:0]     i_wr_data,
        
        output wire [CHANS-1:0][DATA_W-1:0]     o_rd_data
    );
    
    localparam BRAM_DW              = 64;
    localparam BRAM_AW              = 9;
    localparam BRAM_CNT             = DATA_W / 64;
    
    wire    [7:0]                       w_wr_en;
    wire    [BRAM_AW-1:0]               w_wr_addr;
    wire    [BRAM_AW-1:0]               w_rd_addr;
    wire    [DATA_W-1:0]                w_wr_data;
    wire    [DATA_W-1:0]                w_rd_data;
    
    reg     [CHANS-1:0][DATA_W-1:0]     r_rd_data;
    reg     [3:0]                       r_port_sel;
    
    assign w_rd_addr = i_rd_addr[r_port_sel];
    assign w_wr_addr = i_wr_addr[r_port_sel];
    assign w_wr_data = i_wr_data[r_port_sel];
    assign w_wr_en = {{8{i_wr_en[r_port_sel]}}};
    
    assign o_rd_data = r_rd_data;
    
    genvar i;
    integer k;
    
            ///////////////////////////////////////////////////////////////////////
			//  READ_WIDTH | BRAM_SIZE | READ Depth  | RDADDR Width |            //
			// WRITE_WIDTH |           | WRITE Depth | WRADDR Width |  WE Width  //
			// ============|===========|=============|==============|============//
			//    37-72    |  "36Kb"   |      512    |     9-bit    |    8-bit   //
			//    19-36    |  "36Kb"   |     1024    |    10-bit    |    4-bit   //
			//    19-36    |  "18Kb"   |      512    |     9-bit    |    4-bit   //
			//    10-18    |  "36Kb"   |     2048    |    11-bit    |    2-bit   //
			//    10-18    |  "18Kb"   |     1024    |    10-bit    |    2-bit   //
			//     5-9     |  "36Kb"   |     4096    |    12-bit    |    1-bit   //
			//     5-9     |  "18Kb"   |     2048    |    11-bit    |    1-bit   //
			//     3-4     |  "36Kb"   |     8192    |    13-bit    |    1-bit   //
			//     3-4     |  "18Kb"   |     4096    |    12-bit    |    1-bit   //
			//       2     |  "36Kb"   |    16384    |    14-bit    |    1-bit   //
			//       2     |  "18Kb"   |     8192    |    13-bit    |    1-bit   //
			//       1     |  "36Kb"   |    32768    |    15-bit    |    1-bit   //
			//       1     |  "18Kb"   |    16384    |    14-bit    |    1-bit   //
			///////////////////////////////////////////////////////////////////////
			
    generate
        for (i = 0; i < BRAM_CNT; i = i+1) begin        :   gen_bram
            BRAM_SDP_MACRO #(
				.BRAM_SIZE("36Kb"), // Target BRAM, "18Kb" or "36Kb"
				.DEVICE("7SERIES"), // Target device: "7SERIES"
				.WRITE_WIDTH(BRAM_DW),    // Valid values are 1-72 (37-72 only valid when BRAM_SIZE="36Kb")
				.READ_WIDTH(BRAM_DW),     // Valid values are 1-72 (37-72 only valid when BRAM_SIZE="36Kb")
				.DO_REG(1'b0),         // Optional output register (0 or 1)
				.INIT_FILE ("NONE"),
				.SIM_COLLISION_CHECK ("ALL"), // Collision check enable "ALL", "WARNING_ONLY",
												//   "GENERATE_X_ONLY" or "NONE"
				.SRVAL(72'h000000000000000000), // Set/Reset value for port output
				.INIT(72'h000000000000000000),  // Initial values on output port
				.WRITE_MODE("READ_FIRST"),  // Specify "READ_FIRST" for same clock or synchronous clocks
												//   Specify "WRITE_FIRST for asynchronous clocks on ports
				.INIT_00(256'h0000000000000000000000000000000000000000000000000000000000000000),
				.INIT_01(256'h0000000000000000000000000000000000000000000000000000000000000000),
				.INIT_02(256'h0000000000000000000000000000000000000000000000000000000000000000),
				.INIT_03(256'h0000000000000000000000000000000000000000000000000000000000000000),
				.INIT_04(256'h0000000000000000000000000000000000000000000000000000000000000000),
				.INIT_05(256'h0000000000000000000000000000000000000000000000000000000000000000),
				.INIT_06(256'h0000000000000000000000000000000000000000000000000000000000000000),
				.INIT_07(256'h0000000000000000000000000000000000000000000000000000000000000000),
				.INIT_08(256'h0000000000000000000000000000000000000000000000000000000000000000),
				.INIT_09(256'h0000000000000000000000000000000000000000000000000000000000000000),
				.INIT_0A(256'h0000000000000000000000000000000000000000000000000000000000000000),
				.INIT_0B(256'h0000000000000000000000000000000000000000000000000000000000000000),
				.INIT_0C(256'h0000000000000000000000000000000000000000000000000000000000000000),
				.INIT_0D(256'h0000000000000000000000000000000000000000000000000000000000000000),
				.INIT_0E(256'h0000000000000000000000000000000000000000000000000000000000000000),
				.INIT_0F(256'h0000000000000000000000000000000000000000000000000000000000000000),
				.INIT_10(256'h0000000000000000000000000000000000000000000000000000000000000000),
				.INIT_11(256'h0000000000000000000000000000000000000000000000000000000000000000),
				.INIT_12(256'h0000000000000000000000000000000000000000000000000000000000000000),
				.INIT_13(256'h0000000000000000000000000000000000000000000000000000000000000000),
				.INIT_14(256'h0000000000000000000000000000000000000000000000000000000000000000),
				.INIT_15(256'h0000000000000000000000000000000000000000000000000000000000000000),
				.INIT_16(256'h0000000000000000000000000000000000000000000000000000000000000000),
				.INIT_17(256'h0000000000000000000000000000000000000000000000000000000000000000),
				.INIT_18(256'h0000000000000000000000000000000000000000000000000000000000000000),
				.INIT_19(256'h0000000000000000000000000000000000000000000000000000000000000000),
				.INIT_1A(256'h0000000000000000000000000000000000000000000000000000000000000000),
				.INIT_1B(256'h0000000000000000000000000000000000000000000000000000000000000000),
				.INIT_1C(256'h0000000000000000000000000000000000000000000000000000000000000000),
				.INIT_1D(256'h0000000000000000000000000000000000000000000000000000000000000000),
				.INIT_1E(256'h0000000000000000000000000000000000000000000000000000000000000000),
				.INIT_1F(256'h0000000000000000000000000000000000000000000000000000000000000000),
				.INIT_20(256'h0000000000000000000000000000000000000000000000000000000000000000),
				.INIT_21(256'h0000000000000000000000000000000000000000000000000000000000000000),
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
				.INIT_76(256'h0000000000000000000000000000000000000000000000000000000000000000),
				.INIT_77(256'h0000000000000000000000000000000000000000000000000000000000000000),
				.INIT_78(256'h0000000000000000000000000000000000000000000000000000000000000000),
				.INIT_79(256'h0000000000000000000000000000000000000000000000000000000000000000),
				.INIT_7A(256'h0000000000000000000000000000000000000000000000000000000000000000),
				.INIT_7B(256'h0000000000000000000000000000000000000000000000000000000000000000),
				.INIT_7C(256'h0000000000000000000000000000000000000000000000000000000000000000),
				.INIT_7D(256'h0000000000000000000000000000000000000000000000000000000000000000),
				.INIT_7E(256'h0000000000000000000000000000000000000000000000000000000000000000),
				.INIT_7F(256'h0000000000000000000000000000000000000000000000000000000000000000),
				
				// The next set of INITP_xx are for the parity bits
				.INITP_00(256'h0000000000000000000000000000000000000000000000000000000000000000),
				.INITP_01(256'h0000000000000000000000000000000000000000000000000000000000000000),
				.INITP_02(256'h0000000000000000000000000000000000000000000000000000000000000000),
				.INITP_03(256'h0000000000000000000000000000000000000000000000000000000000000000),
				.INITP_04(256'h0000000000000000000000000000000000000000000000000000000000000000),
				.INITP_05(256'h0000000000000000000000000000000000000000000000000000000000000000),
				.INITP_06(256'h0000000000000000000000000000000000000000000000000000000000000000),
				.INITP_07(256'h0000000000000000000000000000000000000000000000000000000000000000),
				
				// The next set of INITP_xx are valid when configured as 36Kb
				.INITP_08(256'h0000000000000000000000000000000000000000000000000000000000000000),
				.INITP_09(256'h0000000000000000000000000000000000000000000000000000000000000000),
				.INITP_0A(256'h0000000000000000000000000000000000000000000000000000000000000000),
				.INITP_0B(256'h0000000000000000000000000000000000000000000000000000000000000000),
				.INITP_0C(256'h0000000000000000000000000000000000000000000000000000000000000000),
				.INITP_0D(256'h0000000000000000000000000000000000000000000000000000000000000000),
				.INITP_0E(256'h0000000000000000000000000000000000000000000000000000000000000000),
				.INITP_0F(256'h0000000000000000000000000000000000000000000000000000000000000000)
			) BRAM_SDP_MACRO_inst (
				.DO(w_rd_data[i*BRAM_DW +: BRAM_DW]),         // Output read data port, width defined by READ_WIDTH parameter
				.DI(w_wr_data[i*BRAM_DW +: BRAM_DW]),         // Input write data port, width defined by WRITE_WIDTH parameter
				.RDADDR(w_rd_addr), // Input read address, width defined by read port depth
				.RDCLK(i_clk),   // 1-bit input read clock
				.RDEN(1'b1),     // 1-bit input read port enable
				.REGCE(1'b0),   // 1-bit input read output register enable
				.RST(i_rst),       // 1-bit input reset
				.WE(w_wr_en),         // Input write enable, width defined by write port depth
				.WRADDR(w_wr_addr), // Input write address, width defined by write port depth
				.WRCLK(i_clk),   // 1-bit input write clock
				.WREN(1'b1)      // 1-bit input write port enable
			);
        end
    endgenerate
    
    always @(posedge i_clk) begin
        r_port_sel <= (i_rst || r_port_sel == CHANS-1) ? 0 : r_port_sel + 1;
    end
    
    initial begin
        r_rd_data = 0;
    end
    
    always @(posedge i_clk) begin
        for (k = 0; k < CHANS; k = k+1) begin
            if (r_port_sel == k) r_rd_data[k] <= w_rd_data;
        end
    end
    
endmodule
*/

module mem_heap #(
        parameter CHANS                 = 3,                    // Total number of address channels per block
        parameter DATA_W                = 64,
        parameter ADDR_W                = 9
    )(
        input wire                              i_wr_clk,
        input wire                              i_rd_clk,
        input wire                              i_rst,
        input wire                              i_wr_en,
        input wire  [ADDR_W-1:0]                i_wr_addr,
        input wire  [DATA_W-1:0]                i_wr_data,
        input wire  [CHANS-1:0][ADDR_W-1:0]     i_rd_addr,
        
        output wire [CHANS-1:0][DATA_W-1:0]     o_rd_data
    );
    
    wire    [7:0]                       w_wr_en;
    
    reg     [CHANS-1:0][DATA_W-1:0]     r_rd_data;
    
    assign w_wr_en = {8{i_wr_en}};
    
    genvar i;
    
            ///////////////////////////////////////////////////////////////////////
			//  READ_WIDTH | BRAM_SIZE | READ Depth  | RDADDR Width |            //
			// WRITE_WIDTH |           | WRITE Depth | WRADDR Width |  WE Width  //
			// ============|===========|=============|==============|============//
			//    37-72    |  "36Kb"   |      512    |     9-bit    |    8-bit   //
			//    19-36    |  "36Kb"   |     1024    |    10-bit    |    4-bit   //
			//    19-36    |  "18Kb"   |      512    |     9-bit    |    4-bit   //
			//    10-18    |  "36Kb"   |     2048    |    11-bit    |    2-bit   //
			//    10-18    |  "18Kb"   |     1024    |    10-bit    |    2-bit   //
			//     5-9     |  "36Kb"   |     4096    |    12-bit    |    1-bit   //
			//     5-9     |  "18Kb"   |     2048    |    11-bit    |    1-bit   //
			//     3-4     |  "36Kb"   |     8192    |    13-bit    |    1-bit   //
			//     3-4     |  "18Kb"   |     4096    |    12-bit    |    1-bit   //
			//       2     |  "36Kb"   |    16384    |    14-bit    |    1-bit   //
			//       2     |  "18Kb"   |     8192    |    13-bit    |    1-bit   //
			//       1     |  "36Kb"   |    32768    |    15-bit    |    1-bit   //
			//       1     |  "18Kb"   |    16384    |    14-bit    |    1-bit   //
			///////////////////////////////////////////////////////////////////////
			
    generate
        for (i = 0; i < CHANS; i = i+1) begin        :   gen_bram
            BRAM_SDP_MACRO #(
				.BRAM_SIZE("36Kb"), // Target BRAM, "18Kb" or "36Kb"
				.DEVICE("7SERIES"), // Target device: "7SERIES"
				.WRITE_WIDTH(DATA_W),    // Valid values are 1-72 (37-72 only valid when BRAM_SIZE="36Kb")
				.READ_WIDTH(DATA_W),     // Valid values are 1-72 (37-72 only valid when BRAM_SIZE="36Kb")
				.DO_REG(1'b1),         // Optional output register (0 or 1)
				.INIT_FILE ("NONE"),
				.SIM_COLLISION_CHECK ("ALL"), // Collision check enable "ALL", "WARNING_ONLY",
												//   "GENERATE_X_ONLY" or "NONE"
				.SRVAL(72'h000000000000000000), // Set/Reset value for port output
				.INIT(72'h000000000000000000),  // Initial values on output port
				.WRITE_MODE("WRITE_FIRST"),  // Specify "READ_FIRST" for same clock or synchronous clocks
												//   Specify "WRITE_FIRST for asynchronous clocks on ports
				.INIT_00(256'h0000000000000000000000000000000000000000000000000000000000000000),
				.INIT_01(256'h0000000000000000000000000000000000000000000000000000000000000000),
				.INIT_02(256'h0000000000000000000000000000000000000000000000000000000000000000),
				.INIT_03(256'h0000000000000000000000000000000000000000000000000000000000000000),
				.INIT_04(256'h0000000000000000000000000000000000000000000000000000000000000000),
				.INIT_05(256'h0000000000000000000000000000000000000000000000000000000000000000),
				.INIT_06(256'h0000000000000000000000000000000000000000000000000000000000000000),
				.INIT_07(256'h0000000000000000000000000000000000000000000000000000000000000000),
				.INIT_08(256'h0000000000000000000000000000000000000000000000000000000000000000),
				.INIT_09(256'h0000000000000000000000000000000000000000000000000000000000000000),
				.INIT_0A(256'h0000000000000000000000000000000000000000000000000000000000000000),
				.INIT_0B(256'h0000000000000000000000000000000000000000000000000000000000000000),
				.INIT_0C(256'h0000000000000000000000000000000000000000000000000000000000000000),
				.INIT_0D(256'h0000000000000000000000000000000000000000000000000000000000000000),
				.INIT_0E(256'h0000000000000000000000000000000000000000000000000000000000000000),
				.INIT_0F(256'h0000000000000000000000000000000000000000000000000000000000000000),
				.INIT_10(256'h0000000000000000000000000000000000000000000000000000000000000000),
				.INIT_11(256'h0000000000000000000000000000000000000000000000000000000000000000),
				.INIT_12(256'h0000000000000000000000000000000000000000000000000000000000000000),
				.INIT_13(256'h0000000000000000000000000000000000000000000000000000000000000000),
				.INIT_14(256'h0000000000000000000000000000000000000000000000000000000000000000),
				.INIT_15(256'h0000000000000000000000000000000000000000000000000000000000000000),
				.INIT_16(256'h0000000000000000000000000000000000000000000000000000000000000000),
				.INIT_17(256'h0000000000000000000000000000000000000000000000000000000000000000),
				.INIT_18(256'h0000000000000000000000000000000000000000000000000000000000000000),
				.INIT_19(256'h0000000000000000000000000000000000000000000000000000000000000000),
				.INIT_1A(256'h0000000000000000000000000000000000000000000000000000000000000000),
				.INIT_1B(256'h0000000000000000000000000000000000000000000000000000000000000000),
				.INIT_1C(256'h0000000000000000000000000000000000000000000000000000000000000000),
				.INIT_1D(256'h0000000000000000000000000000000000000000000000000000000000000000),
				.INIT_1E(256'h0000000000000000000000000000000000000000000000000000000000000000),
				.INIT_1F(256'h0000000000000000000000000000000000000000000000000000000000000000),
				.INIT_20(256'h0000000000000000000000000000000000000000000000000000000000000000),
				.INIT_21(256'h0000000000000000000000000000000000000000000000000000000000000000),
				.INIT_22(256'h0000000000000000000000000000000000000000000000000000000000000000),
				.INIT_23(256'h0000000000000000000000000000000000000000000000000000000000000000),
				.INIT_24(256'h0000000000000000000000000000000000000000000000000000000000000000),
				.INIT_25(256'h0000000000000000000000000000000000000000000000000000000000000000),
				.INIT_26(256'h0000000000000000000000000000000000000000000000000000000000000000),
				.INIT_27(256'h0000000000000000000000000000000000000000000000000000000000000000),
				.INIT_28(256'h0000000000000000000000000000000000000000000000000000000000000000),
				.INIT_29(256'h0000000000000000000000000000000000000000000000000000000000000000),
				.INIT_2A(256'h0000000000000000000000000000000000000000000000000000000000000000),
				.INIT_2B(256'h0000000000000000000000000000000000000000000000000000000000000000),
				.INIT_2C(256'h0000000000000000000000000000000000000000000000000000000000000000),
				.INIT_2D(256'h0000000000000000000000000000000000000000000000000000000000000000),
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
				.INITP_01(256'h0000000000000000000000000000000000000000000000000000000000000000),
				.INITP_02(256'h0000000000000000000000000000000000000000000000000000000000000000),
				.INITP_03(256'h0000000000000000000000000000000000000000000000000000000000000000),
				.INITP_04(256'h0000000000000000000000000000000000000000000000000000000000000000),
				.INITP_05(256'h0000000000000000000000000000000000000000000000000000000000000000),
				.INITP_06(256'h0000000000000000000000000000000000000000000000000000000000000000),
				.INITP_07(256'h0000000000000000000000000000000000000000000000000000000000000000),
				
				// The next set of INITP_xx are valid when configured as 36Kb
				.INITP_08(256'h0000000000000000000000000000000000000000000000000000000000000000),
				.INITP_09(256'h0000000000000000000000000000000000000000000000000000000000000000),
				.INITP_0A(256'h0000000000000000000000000000000000000000000000000000000000000000),
				.INITP_0B(256'h0000000000000000000000000000000000000000000000000000000000000000),
				.INITP_0C(256'h0000000000000000000000000000000000000000000000000000000000000000),
				.INITP_0D(256'h0000000000000000000000000000000000000000000000000000000000000000),
				.INITP_0E(256'h0000000000000000000000000000000000000000000000000000000000000000),
				.INITP_0F(256'h0000000000000000000000000000000000000000000000000000000000000000)
			) BRAM_SDP_MACRO_inst (
				.DO(o_rd_data[i]),         // Output read data port, width defined by READ_WIDTH parameter
				.DI(i_wr_data),         // Input write data port, width defined by WRITE_WIDTH parameter
				.RDADDR(i_rd_addr[i]), // Input read address, width defined by read port depth
				.RDCLK(i_rd_clk),   // 1-bit input read clock
				.RDEN(1'b1),     // 1-bit input read port enable
				.REGCE(1'b1),   // 1-bit input read output register enable
				.RST(i_rst),       // 1-bit input reset
				.WE(w_wr_en),         // Input write enable, width defined by write port depth
				.WRADDR(i_wr_addr), // Input write address, width defined by write port depth
				.WRCLK(i_wr_clk),   // 1-bit input write clock
				.WREN(1'b1)      // 1-bit input write port enable
			);
        end
    endgenerate
    
endmodule
